Reighvhen/FM-radio-w-esp32-project/V4/V4.1/sketch.ino

//UNEDITED
//This has 1 led and  2 potentiometers for volume control (limit up to volume 4) and free tuning of frequency
//The execution order is:
                          // Global variable declarations/initializations — once, at the very start
                          // setup() — once, right after
                          // loop() — runs, finishes, then immediately runs again, forever
  //You never go back to setup() unless the ESP32 resets or loses power. 

#include <RDA5807.h>
RDA5807 rx;
#define Bmute 18
#define red 16
#define green 17
#define blue 19

byte lastMuteState;

bool isOn = false; 

int lastFreq = 0;

void setup()
{ //-----------------------------
  pinMode(Bmute, INPUT_PULLUP); //This tells the ESP32 "GPIO pin Bmute is an input, and enable the internal pull-up resistor."
  lastMuteState = digitalRead(Bmute);//This reads the initial state of the button the moment the program starts 
                                        //— before any button has been pressed. 
                                        // HIGH = not pressed, LOW = pressed cause its going to connect to GND thus giving us 0V


  pinMode(red, OUTPUT);
  pinMode(green, OUTPUT);
  pinMode(blue, OUTPUT);
  digitalWrite(red, HIGH);
  digitalWrite(green, LOW);
  digitalWrite(blue, LOW);
  
  //-----------------------------
  Serial.begin(115200);
  rx.setup(); //call rx.powerUp: initialize I2C communication & (DMUTE, DHIZ, ENABBLE)=1, & VOLUME=0

  rx.setMute(true); //true=muted; since the rx.setup unmutes it, we want to unmute it again so that it would be quiet when just plug in to power supply

}

void loop()
{

  
  byte nowMuteState = digitalRead(Bmute); // read the current state of the mute button

  //Then we can compare the current state to the last one (from the previous execution of the loop function). 4 possibilities here:
      // 1. LOW -> LOW (last -> current).
      // 2. LOW -> HIGH.
      // 3. HIGH -> LOW.
      // 4. HIGH -> HIGH.
        // if last =! current state, it means that the button has been pressed, 
        // if it was equal, it means that the button was not pressed cause the state stayed the same
  // we only enter the next block of code if the current and last state are different
  if (lastMuteState != nowMuteState) 
  { 
    
    //At this point we have only 2 possibilities left:
      // 1. Either the previous state was LOW, and the current state is HIGH (pressed to not pressed). --> release
      // 2. Or the previous state was HIGH, and the current state is LOW (not pressed to pressed). --> push
    // We are interested in the moment the button goes down (pressed), not when it comes back up. 
      // Because ppl expect things to happen when button is pushed and not when they release.
    if (isOn == false && lastMuteState == HIGH && nowMuteState == LOW ) // if are off (currently) and press the button == turning ON
    {
      rx.setMute(false);

      //turning on the green led and off the red
      analogWrite(green, 255);
      analogWrite(red, 0); 
      isOn = true;
    }

    else if (isOn == true && lastMuteState == HIGH && nowMuteState == LOW ) // if are on and press the button == turning OFF
    {
      rx.setMute(true);
            
      //turning on the red led and off the green
      analogWrite(red, 255); 
      analogWrite(green, 0);
      isOn = false;
    }

    delay(50);
    // now we move the current state to be the previous state so next time the loops run again it has the correct prev state
    lastMuteState = nowMuteState;
    
  }


  if (isOn == true) // only if we are on can we use the volume potentiometer
  {
    // analogRead() is never perfectly stable — even with the knob completely still,
    // it fluctuates by a few counts due to electrical noise. If we called
    // rx.setFrequency() every loop cycle, the chip would constantly be retuning
    // and never have time to actually lock onto a station and play audio.
    
    // To fix this, we only call rx.setFrequency() when the new frequency differs
    // from the last frequency we set by more than 10 units. Anything less than 10
    // is considered electrical noise and gets ignored. Only intentional knob
    // movements cause a meaningful change greater than 10, triggering a retune.

    // lastFreq remembers the last frequency we actually set, giving us something
    // to compare against each cycle to detect real vs noise changes.
    int newFreq = map(analogRead(32), 0, 4095, 8750, 10800);
    if (abs(newFreq - lastFreq) > 11) 
    {
      rx.setFrequency(newFreq);
      delay(50);
      lastFreq = newFreq;
    }
    rx.setVolume(4);
  }
 
}
