Reighvhen/FM-radio-w-esp32-project/(commit log)

2026-07-28 Update notes on RDA5807M default state and power settings
    Clarified the default state of the radio module and added information about Power Up.
2026-07-29 Implement button to toggle mute on RDA5807
    Added functionality for a button to toggle mute state.
2026-07-29 Update notes for ESP32 FM Radio Project V2
    Expanded project documentation for ESP32 FM Radio V2, detailing the addition of a power toggle button, lessons learned, and technical insights on button detection, debouncing, and audio signal observations.
2026-08-04 Implement improvement in radio control with volume and LED indicators
2026-08-09 Update notes for ESP32 FM Radio Project V3.1
    Expanded project notes for ESP32 FM Radio Version 3.1, detailing features, lessons learned, and volume logic.
2026-08-09 Refactor sketch.ino by removing unused buttons
    Removed unused button definitions and cleaned up comments for clarity.
2026-08-09 Revamp volume control to use potentiometer
    This version replaces volume buttons with a potentiometer for smoother volume control, updates LED control to use analogWrite, and discusses wiring and functionality of the potentiometer.
2026-08-09 Refactor sketch.ino to remove unused buttons
    Removed unused volume button functionality and cleaned up comments.
2026-08-10 Refine comments in sketch.ino for better clarity
    Updated comments for clarity and corrected minor grammatical issues.
    [sketch.ino]
2026-08-10 Add free frequency tuning for ESP32 FM Radio
    This version introduces free frequency tuning across the FM band using a second potentiometer connected to GPIO 32, allowing users to tune to any FM station. It also includes explanations of the tuning process, challenges faced, and potential improvements.
